Shubhk7/deca-discrete-alu-processor/(list of files, drawings)

Other design files:
simulation/dual_mode_8bit_alu_processor.circ
