Shubhk7/deca-discrete-alu-processor/(commit log)

2026-10-17 feat: upgrade to dual-mode 8-bit ALU with 74LS181 verifier and add progress bars
    [alu_4bit_processor.circ, dual_mode_8bit_alu_processor.circ]
2026-10-17 Update for Pin Diagram
2026-10-18 refactor: complete architecture migration to discrete 74HCT gate-level ALU
    [dual_mode_8bit_alu_processor.circ]
2026-10-19 feat: complete dual-mode hybrid ALU (74LS181 + 74283 + 7485) with 3-board control
    [dual_mode_8bit_alu_processor.circ]
2026-10-20 docs: add full-fledged master vector circuit schematic diagram
2026-10-20 feat(easyeda): add 1-click importable schematic file for EasyEDA
    [DECA_ALU_EasyEDA_Schematic.sch]
2026-10-20 fix(easyeda): scale schematic grid to standard millimeters for clean EasyEDA layout
    [DECA_ALU_EasyEDA_Schematic.sch]
2026-10-20 feat(hardware): generate ANSI/IEEE symbol-based electrical schematic SVG
2026-10-20 fix(hardware): update adder to 74LS83N (pin 5 VCC, pin 12 GND), XOR to 74HC86N, and gates to 74HCT
2026-10-22 fix(hardware): harmonize ESP32-S3 GPIO pin mapping and 74LS83N pinout with Master Wiring Guide
    [arduino_r4_scoreboard.ino]
2026-10-22 fix(docs): resolve match pin D12, carry cascade IC6 invert, 9-pair dividers, and 12-IC BOM in report
2026-10-22 fix(docs): correct voltage divider resistor count in PERFBOARD_SOLDERING_GUIDE Phase 2 from thirteen to nine
2026-10-22 fix(schematic): correct 74LS181 pinout and fix XML mathtext parse error in Circuit_Diag.py
2026-10-22 fix(hardware_docs): clean Circuit_Diag.py with bus trunks, correct 74LS181 pinout & fix 74LS283 note in PINOUTS_AND_SCHEMATICS
2026-10-25 feat(alternative): add complete DECA Dual 4-Bit Cascaded 8-Bit Hybrid ALU project (74LS181N x Arduino R4 WiFi with 12x8 LED Matrix HUD)
2026-10-25 feat(display): add optional 0.96 inch I2C OLED support to ESP32 firmware
2026-10-25 feat(r4): enable internal INPUT_PULLDOWN on upper inputs and opcode lines to save physical resistors
