Shubhk7/deca-discrete-alu-processor/(notices)

Notices in the files:
README.md:
License: MIT
